alantrundle/bluetooth_app/README.md

# Project
* SwiftUI × CoreBluetooth Sample Code ...
# Built With
* CoreBluetooth
# Versioning
* target -> iOS 14.1 ↑
* Xcode --12.4
* Swift -- 5.3
* SwiftUI -- 2.0
# Authors
* Alan Trundle

# bluetooth_app
#
