alantrundle/bluetooth_app/hardware/NFC_ESP32_V2/NFC_ESP32_V2.kicad_pcb

## KiCad design hardware/NFC_ESP32_V2/NFC_ESP32_V2.kicad_pcb (2024-12-26)

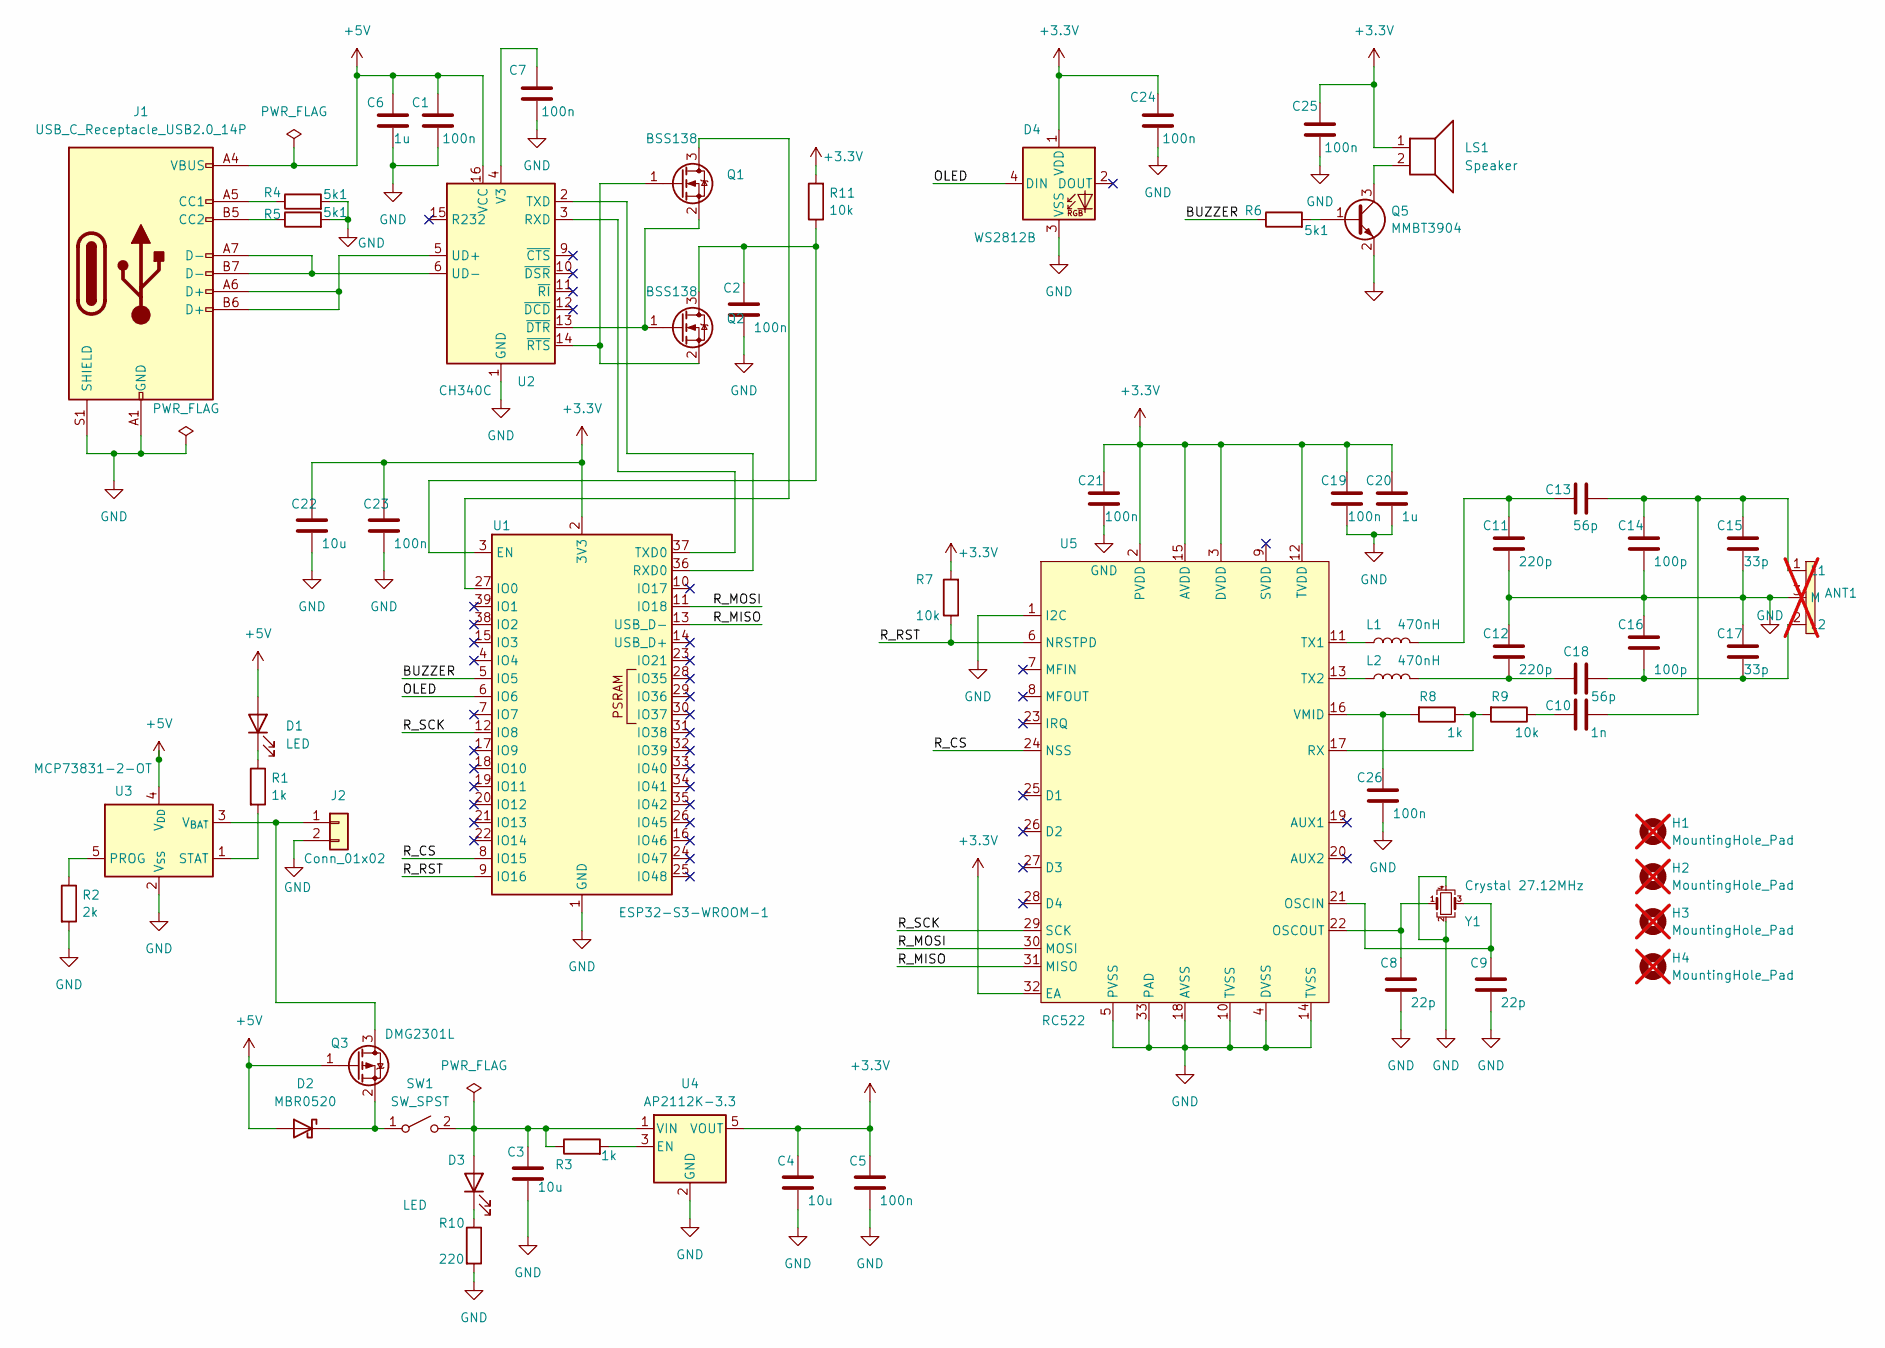
[picture p1: schematic NFC_ESP32_V2.kicad_sch]

Parts:
ANT1: RFID_Antenna2; not fitted
C1, C2, C5, C7, C19, C21, C23, C24, C25, C26: 100n; C_0603_1608Metric; LCSC C5137636
C3, C4, C22: 10u; C_0805_2012Metric_Pad1.18x1.45mm_HandSolder; LCSC C15850
C6, C20: 1u; C_0603_1608Metric; LCSC C1592
C8, C9: 22p; C_0603_1608Metric; LCSC C105620
C10: 1n; C_0603_1608Metric; LCSC C1523
C11, C12: 220p; C_0603_1608Metric
C13, C18: 56p; C_0603_1608Metric
C14, C16: 100p; C_0603_1608Metric
C15, C17: 33p; C_0603_1608Metric
D1, D3: LED; LED_0603_1608Metric
D2: MBR0520; D_SOD-123; LCSC C77335
D4: WS2812B; LED_WS2812B_PLCC4_5.0x5.0mm_P3.2mm; LCSC C114586
H1, H2, H3, H4: MountingHole_Pad; MountingHole_2.2mm_M2; not fitted
J1: USB_C_Receptacle_USB2.0_14P; USB_C_Receptacle_JAE_DX07S016JA1R1500; LCSC C3197885
J2: Conn_01x02; JST_ZH_S2B-ZR-SM4A-TF_1x02-1MP_P1.50mm_Horizontal; LCSC C20422588
L1, L2: 470nH; L_0603_1608Metric_Pad1.05x0.95mm_HandSolder; LCSC C280285
LS1: Speaker; Buzzer_TDK_PS1240P02BT_D12.2mm_H6.5mm; LCSC C76873
Q1, Q2: BSS138; SOT-23; LCSC C40912
Q3: DMG2301L; SOT-23; LCSC C7472914
Q5: MMBT3904; SOT-23; LCSC C2923360
R1, R3, R8: 1k; R_0603_1608Metric
R2: 2k; R_0603_1608Metric
R4, R5, R6: 5k1; R_0603_1608Metric
R7, R9, R11: 10k; R_0603_1608Metric
R10: 220; R_0603_1608Metric
SW1: SW_SPST; SW_Slide_SPDT_Angled_CK_OS102011MA1Q; LCSC C226259
U1: ESP32-S3-WROOM-1
U2: CH340C; SOIC-16_3.9x9.9mm_P1.27mm; LCSC C84681
U3: MCP73831-2-OT; SOT-23-5; LCSC C424093
U4: AP2112K-3.3; SOT-23-5; LCSC C51118
U5: RC522; HVQFN-32-1EP_5x5mm_P0.5mm_EP3.1x3.1mm_ThermalVias; LCSC C41361612
Y1: Crystal 27.12MHz; Crystal_SMD_3225-4Pin_3.2x2.5mm; LCSC C164053

Connections:
+3.3V: C4.1, C5.1, C19.1, C20.1, C21.1, C22.1, C23.1, C24.1, C25.1, D4.1 (VDD), LS1.1, R7.2, R11.2, U1.2 (3V3), U4.5 (VOUT), U5.2 (PVDD), U5.3 (DVDD), U5.12 (TVDD), U5.15 (AVDD), U5.32 (EA)
+5V: C1.1, C6.1, D1.2 (A), D2.2 (A), J1.A4 (VBUS), J1.A9 (VBUS), J1.B4 (VBUS), J1.B9 (VBUS), Q3.1 (G), U2.16 (VCC), U3.4 (V_{DD})
/BUZZER: R6.1, U1.5 (IO5)
/OLED: D4.4 (DIN), U1.6 (IO6)
/R_CS: U1.8 (IO15), U5.24 (NSS)
/R_MISO: U1.13 (USB_D-), U5.31 (MISO)
/R_MOSI: U1.11 (IO18), U5.30 (MOSI)
/R_RST: R7.1, U1.9 (IO16), U5.6 (NRSTPD)
/R_SCK: U1.12 (IO8), U5.29 (SCK)
GND: ANT1.3 (M), C1.2, C2.2, C3.2, C4.2, C5.2, C6.2, C7.2, C8.2, C9.2, C11.2, C12.1, C14.2, C15.2, C16.1, C17.1, C19.2, C20.2, C21.2, C22.2, C23.2, C24.2, C25.2, C26.2, D4.3 (VSS), J1.A1 (GND), J1.A12 (GND), J1.B1 (GND), J1.B12 (GND), J1.S1 (SHIELD), J2.2, Q5.2 (E), R2.2, R4.2, R5.2, R10.2, U1.1 (GND), U1.40 (GND), U1.41 (GND), U2.1 (GND), U3.2 (V_{SS}), U4.2 (GND), U5.1 (I2C), U5.4 (DVSS), U5.5 (PVSS), U5.10 (TVSS), U5.14 (TVSS), U5.18 (AVSS), U5.33 (PAD), Y1.2, Y1.4
unnamed: ANT1.1 (L1), C10.2, C13.2, C14.1, C15.1
unnamed: ANT1.2 (L2), C16.2, C17.2, C18.2
unnamed: C10.1, R9.1
unnamed: C11.1, C13.1, L1.2
unnamed: C12.2, C18.1, L2.2
unnamed: D1.1 (K), R1.1
unnamed: D2.1 (K), Q3.2 (S), SW1.1 (A)
unnamed: C3.1, D3.2 (A), R3.1, SW1.2 (B), U4.1 (VIN)
unnamed: D3.1 (K), R10.1
unnamed: J1.A5 (CC1), R4.1
unnamed: J1.B5 (CC2), R5.1
unnamed: J2.1, Q3.3 (D), U3.3 (V_{BAT})
unnamed: Q1.3 (D), U1.27 (IO0)
unnamed: Q1.1 (G), Q2.2 (S), U2.14 (~RTS)
unnamed: Q1.2 (S), Q2.1 (G), U2.13 (~DTR)
unnamed: C2.1, Q2.3 (D), R11.1, U1.3 (EN)
unnamed: Q5.1 (B), R6.2
unnamed: LS1.2, Q5.3 (C)
unnamed: U1.36 (RXD0), U2.2 (TXD)
unnamed: U1.37 (TXD0), U2.3 (RXD)
unnamed: J1.A6 (D+), J1.B6 (D+), U2.5 (UD+)
unnamed: J1.A7 (D-), J1.B7 (D-), U2.6 (UD-)
unnamed: C7.1, U2.4 (V3)
unnamed: R2.1, U3.5 (PROG)
unnamed: R1.2, U3.1 (STAT)
unnamed: R3.2, U4.3 (EN)
unnamed: C9.1, U5.21 (OSCIN), Y1.3
unnamed: C8.1, U5.22 (OSCOUT), Y1.1
unnamed: R8.1, R9.2, U5.17 (RX)
unnamed: L1.1, U5.11 (TX1)
unnamed: L2.1, U5.13 (TX2)
unnamed: C26.1, R8.2, U5.16 (VMID)

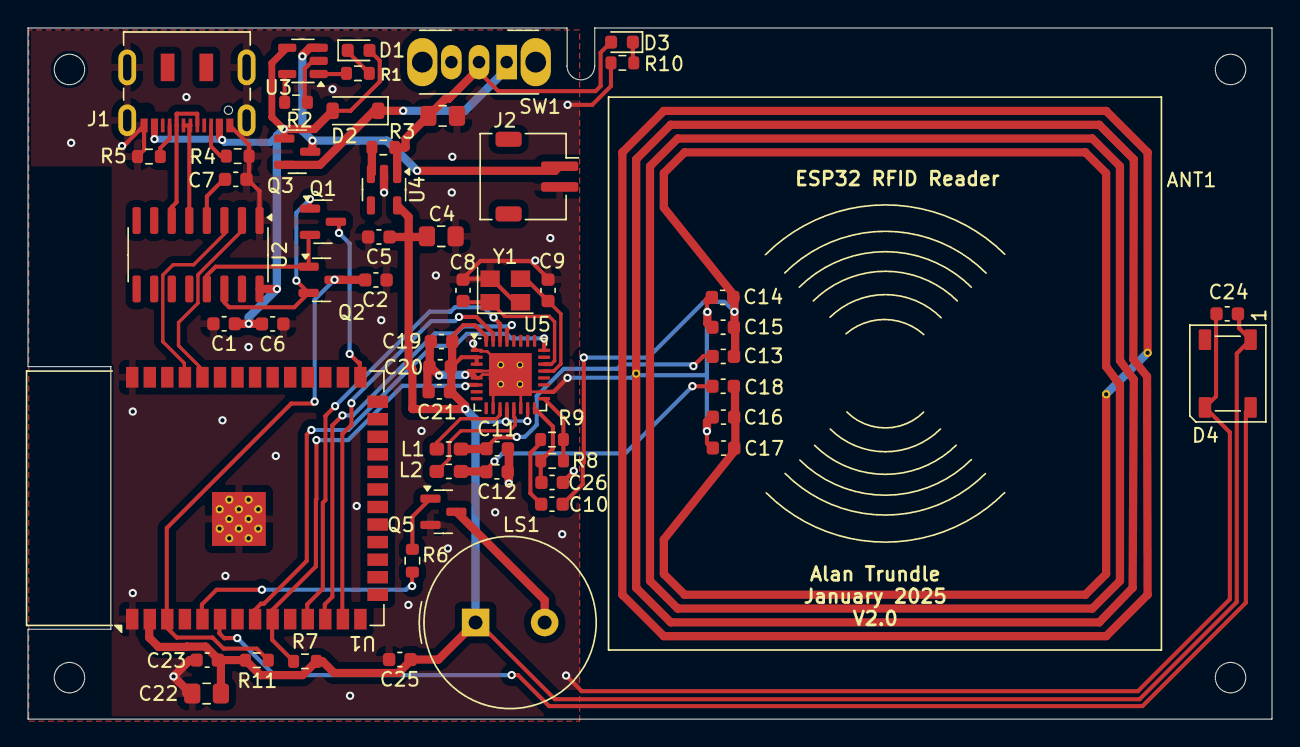
[picture p2: board NFC_ESP32_V2.kicad_pcb from above]

Board: 2 copper layers, 90.0 x 50.0 mm, 62 parts (0 on the bottom side), 42 nets.
