alantrundle/bluetooth_app/(threads)

Thread 1 (2024-12-17):

hardware: USB data lines D+ and D- are swapped

ribbotson, 2024-12-17:
Error in schenatic caarried through to board.
Require Swap

Thread 2 (2024-12-17):

Board is designed for ESP32 WROOM but now intend to use ESP32 S3 with PSRAM

ribbotson, 2024-12-17:
ESP32 S3 has compatible but in identical pinout to standard ESP32. Package has two additional pins in footprint and pin numbering is different.
ESP32 has flexibility in pin allocation, but the pins used for the WS2812B and buzzer may conflict with Octal PSRAM pins.
Propose relayout board with S3 footprint and move buzzer and WS2812B pins

ribbotson, 2024-12-20:
OLED and buzzer pins hand wired to IO6 and IO5 on prototype PCB
Schematic and PCB updated in V1.1 to reflect, but best to move to V2.0

Thread 3 (2024-12-17):

Hardware: Incorrect Crystal Pin on RC522

ribbotson, 2024-12-17:
The scematic symbol for the RC522 is incorrect. OSCIN should be on pin 21.
This error carries through schematic to board

ribbotson, 2024-12-20:
Handwire modification to V1.0 PCB
Symbol, schematic amd PCB updated to V1.1

Closed 2024-12-20.

Thread 4 (2024-12-17):

Hardware: RC522 requires 3.3V power to AVDD

ribbotson, 2024-12-17:
Connect pin AVDD Pin 15 to 3.3V supply.
may need to move decoupling capacitor

ribbotson, 2024-12-20:
handwire modificaion to V1.0 prototype.
Schematic and PCB updated to V1.1

Closed 2024-12-20.
