alantrundle/bluetooth_app/(commit log)

2024-11-30 Added kicad hardware files
    [BOM-NFC_ESP32.csv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]
2024-12-16 ESP32 first commit
2024-12-20 Changed to resolve issues on Version 1.0
    Change RC522 symbol and fix crystal pins
    Swap D- and D+
    Move OLED and buzzer pins
    Power AVDD on RC522
    [NFC_ESP32.kicad_pcb, NFC_ESP32.kicad_sch]
2024-12-26 Added V2 Kicad directory and files
    Add NFC_ESP32_V2 directory an Kicad files.
    V2 Kicad updated to use ESP32 S3 in schematic and PCB
    [NFC_ESP32_V2.kicad_pcb, NFC_ESP32_V2.kicad_sch]
